gabrielcammany/Walkie-textie/PhaseTwo/README.md

# Phase Two - The receiver

This phase consists of creating the receiver of our custom RF protocol using the [Manchester Code](https://en.wikipedia.org/wiki/Manchester_code) with a 100bps transmission rate.

As this phase is quite extensive, I've separated the explanation in two different files. 

## [Modules](MODULES.md)
Explanation of each module.

## [C Cooperative Programming](CODE.md)
How I've developed and structured the code to accomplish the project using C and the cooperative programming approach.

## Electric Schema

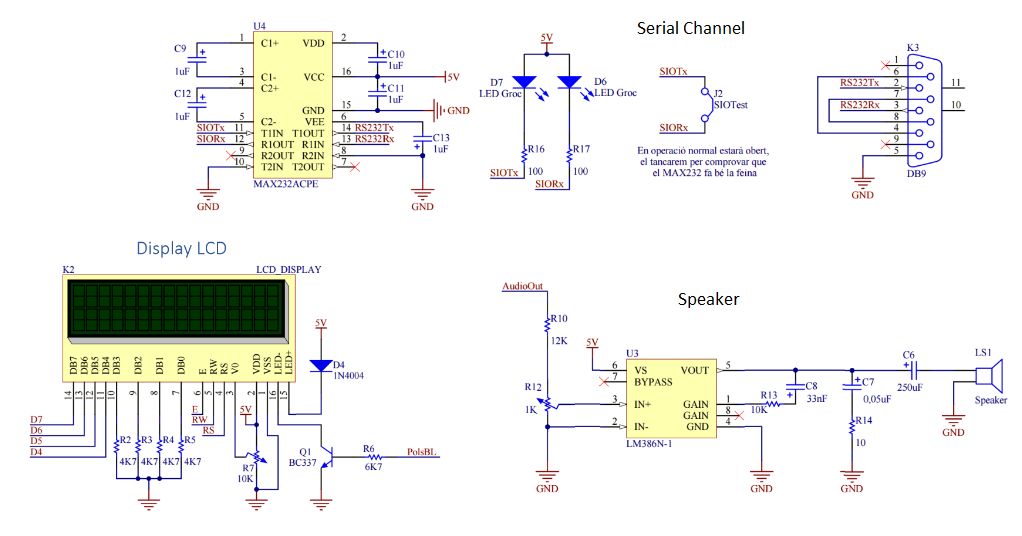
[picture p3: PhaseTwo/images/ElectricSchema.PNG]

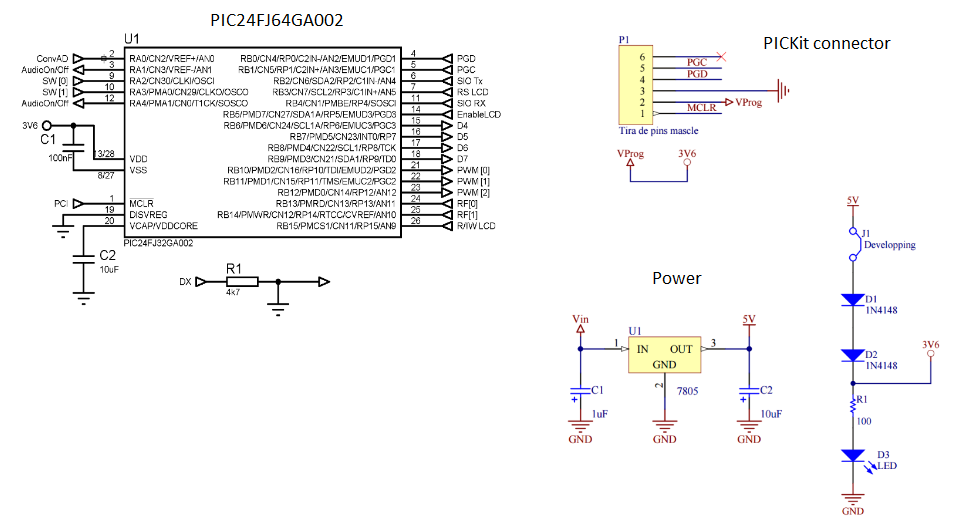
[picture p4: PhaseTwo/images/ElectricSchema_2.PNG]


## Board

Here is a picture of the physical board:

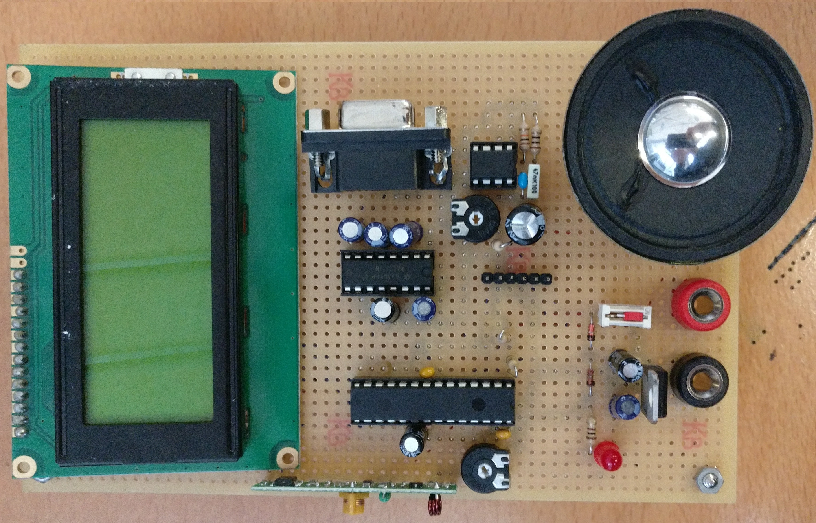
[picture p5: PhaseTwo/images/Board.jpg]
