gabrielcammany/Walkie-textie/(list of files, drawings)

Other design files:
PhaseOne/EsquemaElectricPic.pdsprj
