gabrielcammany/Walkie-textie/PhaseTwo/Code/src/SiTSio.c

#include "SiTSio.h"



static char BufferRX[BUFFER_RX_SIZE];
static char* BufferTX[BUFFER_TX_SIZE];
static unsigned char IniciTx, IniciRx, FiTx, FiRx;
static unsigned char  QuantsRX, QuantsTX;


static char estat;

static void PosaRX(char);
static char TreuRX(void);
static void PosaTX(char*);
static char* TreuTX(void);



void SiInit(void){
//Post: Inicialitza la SIO als pins RP2 (Tx) i RP4(Rx) i demana un timer (de moment passo d'interrupcions)
    // Unlock registers
    __builtin_write_OSCCONL(OSCCON & 0xBF);  //Datasheet dixit (pag 110)

    RPOR1bits.RP2R= 3; //Taula 10-3 del datasheet (pag 109)

    RPINR18bits.U1RXR= 4; //Vull el RP4 de input

    //Lock registers
    __builtin_write_OSCCONL(OSCCON | 0x40);  //Datasheet dixit (pag 110)

    //Configurem la SIO

    U1BRG=103; //9600 bauds  
    U1MODEbits.UARTEN = 1;
    U1MODEbits.UEN=0; //Sense flow control
    U1MODEbits.BRGH=0;
    U1MODEbits.PDSEL = 0; //8 bits de dades i sense paratitat
    U1MODEbits.STSEL = 0;  // 1 Stop bit;
    U1STAbits.UTXEN = 1;
    estat = 0;
    // Activo les interrupcions
    IEC0bits.U1RXIE = 1;
    QuantsTX = QuantsRX = IniciRx = IniciTx = FiRx = FiTx = 0;
}



static char *temporal;

void MotorSIO(void){
    switch(estat){
        case 0:
            if (QuantsTX > 0){
                estat = 1;
            }
            break;
        case 1:
            temporal=TreuTX();
            estat = 2;
            break;
        case 2:
            if (*temporal)
                estat = 3;
            else
                estat = 0;
            break;
        case 3:
            if (U1STAbits.TRMT != 0){
                U1TXREG = *temporal++;
                U1STAbits.UTXEN = 1;
                estat=2;
            }
            break;
    }
}



void SiPuts(char *s) {
    //Versió vintage
	while(*s) SiSendChar(*s++); 
}

//Provo de fer un invent cooperatiu ja que si char *s és molt llarg
//Amorro tots els motors cooperatius

void SiPutsCooperatiu(char *s) {
    //Pre: La referència de char *s és o bé un const char o bé puc garantir que
    //     no es sobreescriurà fins que no l'hagi enviat...
    //Post: Encua *s a la cua de cadenes per enviar...
    PosaTX(s);
}



int SiCharAvail(void) {
// Pre: retorna el nombre de car?cters rebuts que no s'han recollit
// amb la funciÛ GetChar encara
	return QuantsRX;
}

char SiGetChar(void) {
// Pre: SiCharAvail() Ès major que zero
// Post: Treu i retorna el primer car?cter de la cua de recepciÛ.
	return TreuRX();
}

void SiSendChar(char c) {
// Post: espera que el car?cter anterior s'hagi enviat i envia aquest
	while(U1STAbits.TRMT == 0) ClrWdt();
	U1TXREG = c;
	U1STAbits.UTXEN = 1;
}

//
//---------------------------End--PUBLIQUES---AREA-----------
//

//
//--------------------------------PRIVADES----AREA-----------
//


static void PosaTX(char *c) {
	BufferTX[IniciTx++] = c;
	if (IniciTx == BUFFER_TX_SIZE) IniciTx = 0;
	QuantsTX++;
}


static char* TreuTX(void) {
	char *tmp;
	tmp = BufferTX[FiTx++];
	if (FiTx == BUFFER_TX_SIZE) FiTx = 0;
	QuantsTX --;
	return tmp;
}



static void PosaRX(char c) {
	BufferRX[IniciRx++] = c;
	if (IniciRx == BUFFER_RX_SIZE) IniciRx = 0;
	QuantsRX++;
}
static char TreuRX(void) {
	char tmp;
	tmp = BufferRX[FiRx++];
	if (FiRx == BUFFER_RX_SIZE) FiRx = 0;
	QuantsRX --;
	return tmp;
}
void __attribute__((interrupt, no_auto_psv)) _U1RXInterrupt(void) {
        IFS0bits.U1RXIF = 0;
	if (U1STAbits.OERR == 1) U1STAbits.OERR = 0;
	PosaRX(U1RXREG);
}
//
//---------------------------End--PRIVADES----AREA-----------
//
