gabrielcammany/Walkie-textie/(commit log)

2017-04-04 Setting up assembler project
2017-04-10 Adding comments and started LEDs transitions
2017-04-10 Started saving, main loop and recieved bytes on assembler code and changing pseudocode from sending RF, main loop and saving in ram plus some code fixing
    [PseudoCode.c, main.asm]
2017-04-11 Both Pseudocode and Assembler code are done. Need to check if there are any bugs.
    [PseudoCode.c, main.asm]
2017-04-11 Build of assembler code successful!
2017-04-13 Bug fixing both assembler and Java code
    [MainWindowView.java, main.asm]
2017-04-14 Blinking and circular leds animation done. Progress bar of RF communication done, but need to check out if bits are being send correctly. So Phase one almost done!
    [PseudoCode.c, main.asm]
2017-04-20 Bug fixing, both java and assembler main code is done.
    [Main.java, MainWindowView.java, main.asm]
2017-04-20 Phase 1 done. Printfs for debugging not cleaned up, to make it easier to debug the next phase.
2017-05-02 Added PWM motor and changed menu.
2017-05-11 Memoria actualitzada i esquemes corresponents
    [EsquemaElectricPic.pdsprj]
2017-05-13 Rebase and PWM done.
2017-05-20 Phase two done. Need code refactor for better optimizations. Some changes in both assembler and java code.
2017-05-21 Separated Propaganda Motor in more states, in order to increase its cooperativeness.
2017-05-21 Some minor bug fixing
    [PrTPropaganda.c]
2017-05-21 New function in PWM.
2017-05-22 Probably last commit. Some changes made due to a lack of configuration for the RF receiver pin.
2017-05-22 Changed PWM motor in order to make it more generic.
2017-05-26 Bug fixed in the RF motor
    [PrTPropaganda.c, TPWM.c]
2017-11-05 Added images and changed project structure
    [EsquemaElectricPic.pdsprj]
